IvyssonUchoa/stm32-predictive-vibration-monitor/Codigo_fonte/Core/Src/main.c

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
/* Includes ------------------------------------------------------------------*/
#include "main.h"

/* USER CODE BEGIN Includes */
#include <stdio.h>
#include <stdarg.h>
#include <string.h>
#include <stdint.h>

#include "MPU6050.h"
#include "ei_wrapper.h"
#include "RMS.h"

/* USER CODE END Includes */

/* USER CODE BEGIN PTD */
#define TEMPO_TURNO_SEGUNDOS  28800 // ou 28800 para 8 horas

#define AMOSTRAS_RMS 250
#define N_AMOSTRAS_IA (AMOSTRAS_RMS * 1 * 3)  // 750 = 250 amostras * 1 segundo * 3 param

#define MARGEM_RMS 1.1f // Limite tolerável de vibração (10%)

#define RMS_parado 10

/* USER CODE END PTD */

I2C_HandleTypeDef hi2c1;

RTC_HandleTypeDef hrtc;

TIM_HandleTypeDef htim2;

UART_HandleTypeDef huart2;

/* USER CODE BEGIN PV */
MPU6050_t mpu;

volatile uint8_t data_ready = 0;

//Buffer para guardar os dados para inferencia
float buffer_ia[N_AMOSTRAS_IA];
volatile int ind_buffer = 0;

//Buffer para guardar os dados para RMS
int buffer_rms_x[AMOSTRAS_RMS];
int buffer_rms_y[AMOSTRAS_RMS];
int buffer_rms_z[AMOSTRAS_RMS];
volatile int sample_index = 0;

const char* classes[] = {
		"instavel nivel 2", // indeciso
		"instavel nivel 3",
		"instavel nivel 1",
		"estavel",
		"instavel nivel 4", // indeciso
		"parado"
};
/* USER CODE END PV */

void SystemClock_Config(void);
static void MX_GPIO_Init(void);
static void MX_I2C1_Init(void);
static void MX_TIM2_Init(void);
static void MX_USART2_UART_Init(void);
static void MX_RTC_Init(void);
/* USER CODE BEGIN 0 */
void ei_printf(const char *format, ...) {
    // Não faz nada! Deixa a IA no modo silencioso.
}

int _write(int file, char *ptr, int len)
{
  // Função responsável por receber os dados da função printf() e enviar pela UART
    HAL_UART_Transmit(&huart2, (uint8_t*)ptr, len, HAL_MAX_DELAY);
    return len;
}

void emitir_sinal_alerta(){
	// Acende Leds e Buzzer para emitir um alerta
	HAL_GPIO_WritePin(GPIOC, BUZZER_Pin, GPIO_PIN_SET);
	HAL_Delay(500);

	HAL_GPIO_WritePin(GPIOA, LED_VERMELHO_Pin, GPIO_PIN_SET);
	HAL_Delay(1200);
	HAL_GPIO_WritePin(GPIOA, LED_VERMELHO_Pin, GPIO_PIN_RESET);
	HAL_Delay(1500);
	HAL_GPIO_WritePin(GPIOA, LED_VERMELHO_Pin, GPIO_PIN_SET);

	HAL_Delay(800);
	HAL_GPIO_WritePin(GPIOC, BUZZER_Pin, GPIO_PIN_RESET);
}

void emitir_sinal_atencao(){
	// Emite um sinal luminoso para indicar a realização de ações específicas

	HAL_GPIO_WritePin(GPIOA, LED_AMARELO_Pin, GPIO_PIN_SET);
	HAL_Delay(1500);
	HAL_GPIO_WritePin(GPIOA, LED_AMARELO_Pin, GPIO_PIN_RESET);
}

void emitir_sinal_sucesso(){
	// Emite um sinal luminoso para indicar que o sistema está funcionando corretamente
	HAL_GPIO_WritePin(GPIOC, LED_VERDE_Pin, GPIO_PIN_SET);
	HAL_Delay(1000);
	HAL_GPIO_WritePin(GPIOC, LED_VERDE_Pin, GPIO_PIN_RESET);
}

/* USER CODE END 0 */

/**
  * @brief  The application entry point.
  * @retval int
  */
int main(void)
{

  /* MCU Configuration--------------------------------------------------------*/

  /* Reset of all peripherals, Initializes the Flash interface and the Systick. */
  HAL_Init();

  /* Configure the system clock */
  SystemClock_Config();

  /* Initialize all configured peripherals */
  MX_GPIO_Init();
  MX_I2C1_Init();
  MX_TIM2_Init();
  MX_USART2_UART_Init();
  MX_RTC_Init();
  /* USER CODE BEGIN 2 */
    HAL_GPIO_WritePin(GPIOC, MPU_Pin, GPIO_PIN_SET); // Liga o MPU pelo transistor
    HAL_Delay(200);

	MPU6050_Init(&mpu, &hi2c1);

	uint8_t Data = 0;
	HAL_I2C_Mem_Write(&hi2c1, MPU6050_ADDR, 0x6B, 1, &Data, 1, 100); // Tira do Sleep
	HAL_I2C_Mem_Write(&hi2c1, MPU6050_ADDR, 0x19, 1, &Data, 1, 100); // Sample rate 1kHz

	HAL_Delay(200);

	if (HAL_I2C_IsDeviceReady(&hi2c1, 0x68 << 1, 3, 100) == HAL_OK){ // se o MPU está funcionando

		emitir_sinal_atencao();
		HAL_Delay(200);
		emitir_sinal_atencao();

		HAL_TIM_Base_Start_IT(&htim2); // Ativa o timer 2
		HAL_PWR_EnableBkUpAccess(); // Ativa o acesso aos dados de backup

		// Lê os dados do MPU
		uint8_t reading_sensor = 1;
		while (reading_sensor) {
			  if (data_ready == 1 && ind_buffer < N_AMOSTRAS_IA) {

				// Atualiza as leituras (Accel e Gyro)
				MPU6050_Update(&mpu);

				// Obtem os dados do MPU
				int ac_x = (int)(mpu.Ax * 1000.0f);
				int ac_y = (int)(mpu.Ay * 1000.0f);
				int ac_z = (int)(mpu.Az * 1000.0f);

				// Guarda os dados coletados nos buffers
				buffer_ia[ind_buffer++] = (float)ac_x;
				buffer_ia[ind_buffer++] = (float)ac_y;
				buffer_ia[ind_buffer++] = (float)ac_z;

				buffer_rms_x[sample_index] = ac_x;
				buffer_rms_y[sample_index] = ac_y;
				buffer_rms_z[sample_index] = ac_z;
				sample_index++;

				// Quando o buffer estiver cheio, sae do loop e faz a inferencia
				if (ind_buffer >= N_AMOSTRAS_IA){
					reading_sensor = 0;
				}

				printf("{\"status\": \"RAW_DATA\", \"message\": \"\", \"data\": {\"x\": %d, \"y\": %d, \"z\": %d} }\r\n", ac_x, ac_y, ac_z);

				data_ready = 0; // baixa a flag
			  }
		}

		HAL_TIM_Base_Stop_IT(&htim2); // para o timer 2
		HAL_Delay(100);

		int result = executar_inferencia(buffer_ia);
		int RMS = calcular_RMS(buffer_rms_x, buffer_rms_y, buffer_rms_z, (int)AMOSTRAS_RMS);

		ind_buffer = 0;
		sample_index = 0;

		// Verifica se o micro acordou pelo standby
		if (__HAL_PWR_GET_FLAG(PWR_FLAG_SB) != RESET){
			// Limpa as flags de Standby e Wakeup
			__HAL_PWR_CLEAR_FLAG(PWR_FLAG_SB);
			__HAL_PWR_CLEAR_FLAG(PWR_FLAG_WU);

			// Começa a parte da decisão do estado do motor
			// Lê o RMS calibrado salvo no RTC Backup Register 1
			uint32_t valor_lido_flash = HAL_RTCEx_BKUPRead(&hrtc, RTC_BKP_DR1);
			int rms_calibrado = (int)valor_lido_flash;

			// Verifica se houve erro durante a calibração
			if (rms_calibrado <= 0){
				printf("{\"status\": \"ERRO\", \"message\": \"RMS Nao Calibrado. Necessario Nova Calibracao. Reset o Sistema\"}\r\n");
				emitir_sinal_alerta();
				HAL_Delay(200);
				emitir_sinal_alerta();

			} else {
				// Se está tudo certo com a calibração
				float rms_error = (rms_calibrado * MARGEM_RMS);

				if ((result == 3 || result == 5) && RMS <= rms_error){
					// Motor parado e RMS dentro da margem aceitável
					printf("{\"status\": \"OK\", \"message\": \"Motor e RMS Estaveis\", \"data\": {\"RMS\": %d, \"RMS_medio\": %d, \"RMS_limite\": %d, \"Classe\": \"%s\"}}\r\n",
					       RMS, (int)rms_calibrado, (int)rms_error, "Estavel");
					emitir_sinal_sucesso();
					HAL_Delay(200);
					emitir_sinal_sucesso();
				}

				else if ((result != 3 && result != 5) && RMS > rms_error){
					// Motor Instável e RMS Instável
					printf("{\"status\": \"ERRO\", \"message\": \"Motor e RMS Instavels. Verificar Saude do Motor\", \"data\": {\"RMS\": %d,  \"RMS_medio\": %d, \"RMS_limite\": %d, \"Classe\": \"%s\"}}\r\n",
					       RMS,(int)rms_calibrado, (int)rms_error, "Instavel");
					emitir_sinal_alerta();
					HAL_Delay(200);
					emitir_sinal_alerta();
				}

				else {
					// Falha na Inferência do Motor ou do Calculo do RMS
					// Pode indicar inicio de anomalia
					printf("{\"status\": \"ERRO\", \"message\": \"Motor OU RMS Instavels. Falha em uma das Leituras. Verificar Saude do Motor e do Sistema\", \"data\": {\"RMS\": %d,  \"RMS_medio\": %d, \"RMS_limite\": %d, \"Classe\": \"%s\"}}\r\n",
					       RMS, (int)rms_calibrado, (int)rms_error, classes[result]);
					emitir_sinal_alerta();
					HAL_Delay(200);
					emitir_sinal_alerta();
				}
			}

		} else { 	// Primeia vez ligado ou Reset de hardware
			// Calibra o RMS para o valor decidido pelo TinyML
			HAL_Delay(5000);

			printf("{\"status\": \"OK\", \"message\": \"Iniciando Calibracao do Sistema\"}\r\n");

				// Salva o RMS correspondente ao estado estável do motor em um registrador de backup
				uint32_t valor_para_salvar = (uint32_t)RMS;
				HAL_RTCEx_BKUPWrite(&hrtc, RTC_BKP_DR1, valor_para_salvar);

				// Indica fim de calibração
				printf("{\"status\": \"OK\", \"message\": \"RMS Calibrado para Motor Estável\", \"data\": {\"RMS_medio\": %d}}\r\n", (int)RMS);

				emitir_sinal_sucesso();
				HAL_Delay(200);
				emitir_sinal_sucesso();
		}

	}
	else{
		// emitir alerta para reset do MPU
		printf("{\"status\": \"ERRO\", \"message\": \"MPU Nao Detectado. Atencao Imediata\"}\r\n");

		__HAL_PWR_CLEAR_FLAG(PWR_FLAG_SB); // Reseta flag de wakeup

		emitir_sinal_alerta();
		HAL_Delay(200);
		emitir_sinal_alerta();

	}

	HAL_Delay(100);

	printf("{\"status\": \"OK\", \"message\": \"Entrando em StandBy\"}\r\n");

	HAL_GPIO_WritePin(GPIOC, MPU_Pin, GPIO_PIN_RESET); // Desliga o MPU pelo transistor

	HAL_RTCEx_DeactivateWakeUpTimer(&hrtc);
	__HAL_PWR_CLEAR_FLAG(PWR_FLAG_WU);

	// Reseta as interrupções de Wakeup
	HAL_PWR_EnableWakeUpPin(PWR_WAKEUP_PIN1);
	HAL_RTCEx_SetWakeUpTimer_IT(&hrtc, TEMPO_TURNO_SEGUNDOS - 1, RTC_WAKEUPCLOCK_CK_SPRE_16BITS);

	// Entra em StandBy
	HAL_PWR_EnterSTANDBYMode();

  /* USER CODE END 2 */

  /* Infinite loop */
  /* USER CODE BEGIN WHILE */
  while (1)
  {
    /* USER CODE END WHILE */

    /* USER CODE BEGIN 3 */
  }
  /* USER CODE END 3 */
}

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
/* USER CODE BEGIN 4 */
void HAL_TIM_PeriodElapsedCallback(TIM_HandleTypeDef *htim) {
    if (htim->Instance == TIM2) {
        data_ready = 1;
    }
}

/* USER CODE END 4 */
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
