IvyssonUchoa/stm32-predictive-vibration-monitor/Codigo_fonte/Core/Inc/main.h

#define B1_Pin GPIO_PIN_13
#define B1_GPIO_Port GPIOC
#define LED_VERDE_Pin GPIO_PIN_0
#define LED_VERDE_GPIO_Port GPIOC
#define BUZZER_Pin GPIO_PIN_1
#define BUZZER_GPIO_Port GPIOC
#define LED_VERMELHO_Pin GPIO_PIN_1
#define LED_VERMELHO_GPIO_Port GPIOA
#define USART_TX_Pin GPIO_PIN_2
#define USART_TX_GPIO_Port GPIOA
#define USART_RX_Pin GPIO_PIN_3
#define USART_RX_GPIO_Port GPIOA
#define LED_AMARELO_Pin GPIO_PIN_4
#define LED_AMARELO_GPIO_Port GPIOA
#define LD2_Pin GPIO_PIN_5
#define LD2_GPIO_Port GPIOA
#define TMS_Pin GPIO_PIN_13
#define TMS_GPIO_Port GPIOA
#define TCK_Pin GPIO_PIN_14
#define TCK_GPIO_Port GPIOA
#define MPU_Pin GPIO_PIN_12
#define MPU_GPIO_Port GPIOC
#define SWO_Pin GPIO_PIN_3
#define SWO_GPIO_Port GPIOB
