IvyssonUchoa/stm32-predictive-vibration-monitor/(notices)

Notices in the files:
Codigo_fonte/Core/Inc/main.h:
Copyright (c) 2026 STMicroelectronics.
All rights reserved.
This software is licensed under terms that can be found in the LICENSE file
